JaredCabot/Dallas-DS1284-DS1286-Tester/DS1284-DS1286 Arduino Uno Adapter Schematic v1.0 20260425.pdf

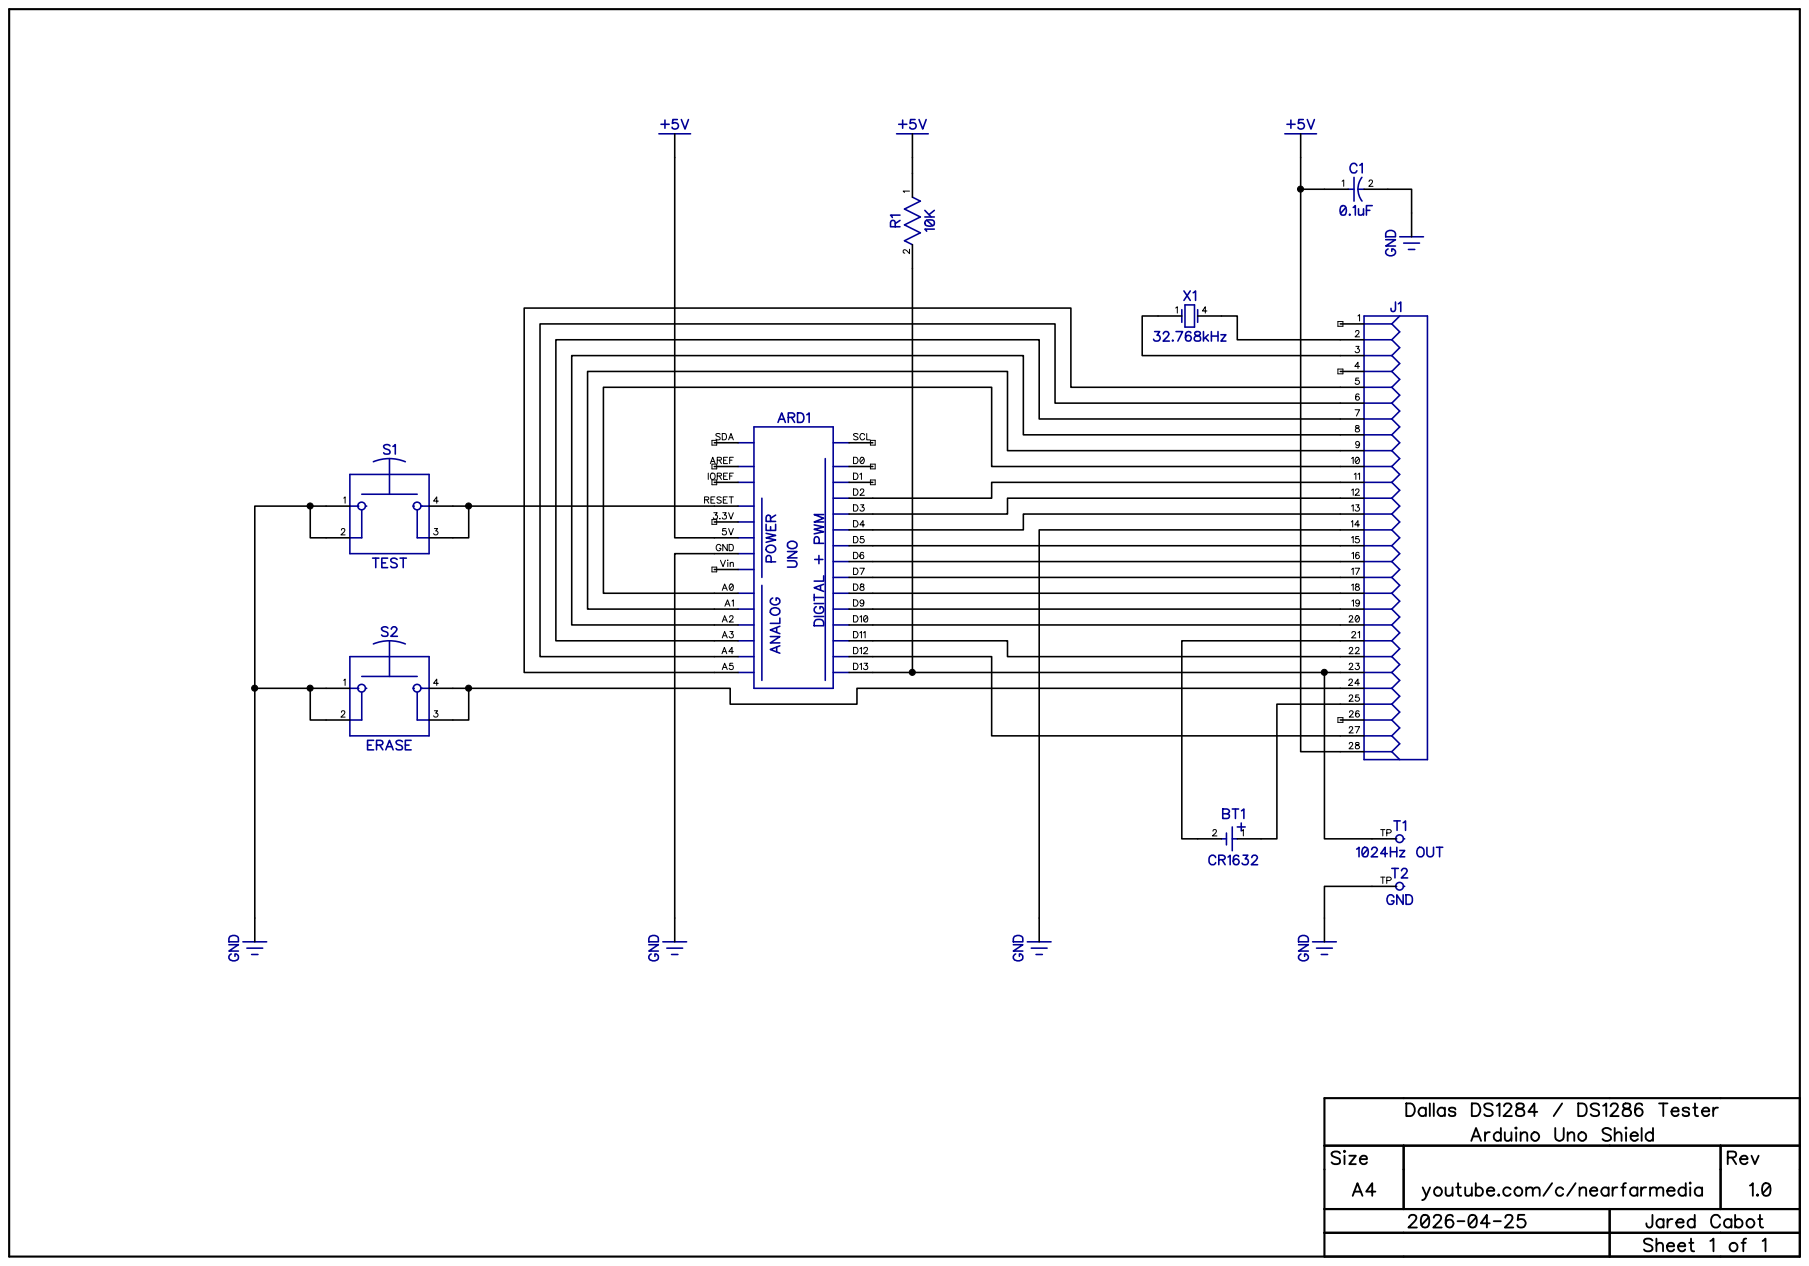
[picture p1: page 1]
