JaredCabot/Dallas-DS1284-DS1286-Tester/DS1284-DS1286 Arduino Uno Adapter Layout v1.0 20260425.pdf

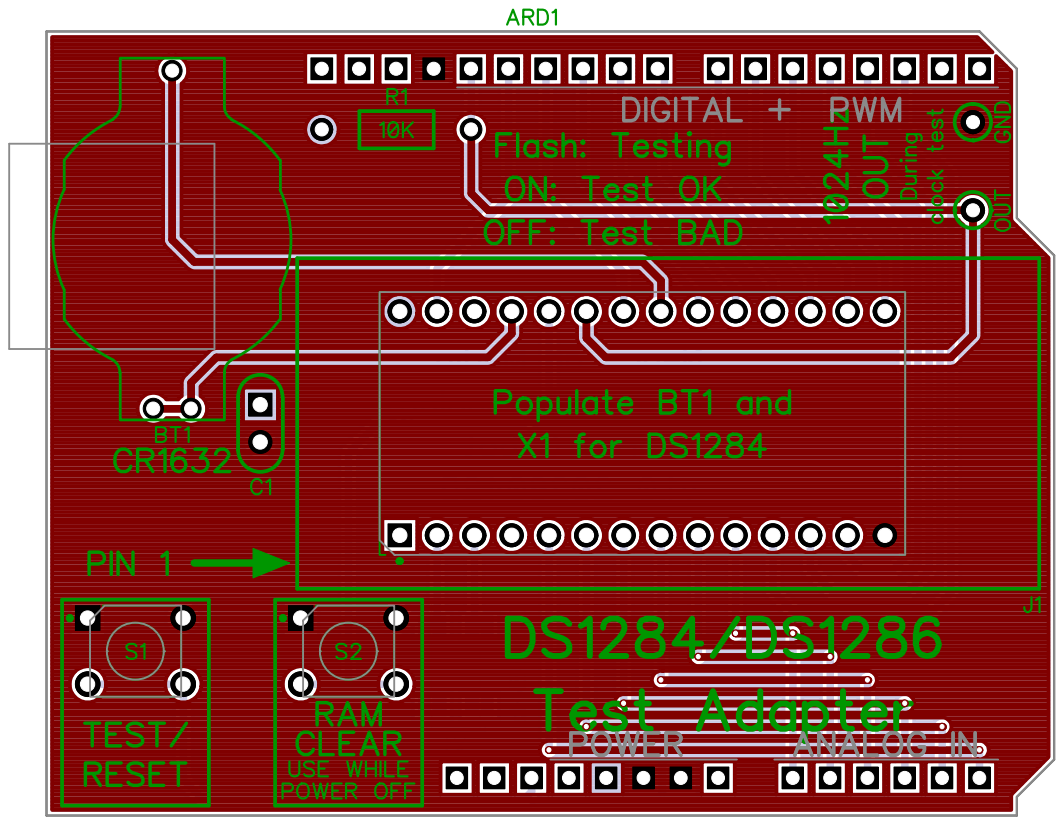
[picture p2: page 1]
